3KUdelta/TapeCounter_Revox_B77_NG/(commit log)

2026-03-23 Add B77 Master Controller v2.1
    - B77_TapeCounter_Master.ino: main file with encoder modes, rewind-to-zero state machine, timeword-based stop thresholds
    - sensor_isr.ino: dual-reel ISR (Option A), one sensor per reel, direction from DIRECTION_PIN
    - runmode.ino: 5ms task for reel period moving averages and STOP detection
    - tape_calc.ino: remaining tape time via Archimedes spiral formula, auto-calibration of tape thickness
    - config.h: all constants, pin assignments, EEPROM layout for Nano Every (256 bytes)
    - README.md: full hardware wiring, calibration, settings and troubleshooting guide
    Hardware: Arduino Nano Every (ATmega4809)
    Target: Revox B77 MKI — HiFiLabor.ch rebuild
    Based on B77_TapeC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
2026-03-23 Add font headers, logo, EZS reference sources; add WIP notice to README
    - tapecounter_16x24.h, tapecounter_21x32.h: OLED fonts required for compilation
    - logo_mst1.h: RevVox splash image
    - EZS_Reference/: original EZS_UNO v1.5 and B77_TapeCounter v2.0 source files
    included for reference (not compiled as part of master project)
    - EZS_Reference/EZS_A77_Schem.pdf: hardware interface schematic
    - README.md: added 'Work in progress! Use with caution!' notice
